PeterPtroc/DDCA_project/constraints/nexys_a7_100t.xdc

# Nexys A7-100T pin constraints for nexys_a7_top.
# Source: https://github.com/Digilent/digilent-xdc/blob/master/Nexys-A7-100T-Master.xdc

## The original pin-only file omitted configuration-bank voltage properties,
## which raised CFGBVS-1. These are the Nexys A7 master-XDC values.
set_property CFGBVS VCCO [current_design]
set_property CONFIG_VOLTAGE 3.3 [current_design]

## 100 MHz system clock
set_property -dict { PACKAGE_PIN E3 IOSTANDARD LVCMOS33 } [get_ports {clk100}]
create_clock -add -name sys_clk -period 10.000 -waveform {0.000 5.000} [get_ports {clk100}]

## CPU_RESETN push button (active low)
set_property -dict { PACKAGE_PIN C12 IOSTANDARD LVCMOS33 } [get_ports {reset_n}]

## Slide switches
set_property -dict { PACKAGE_PIN J15 IOSTANDARD LVCMOS33 } [get_ports {sw[0]}]
set_property -dict { PACKAGE_PIN L16 IOSTANDARD LVCMOS33 } [get_ports {sw[1]}]
set_property -dict { PACKAGE_PIN M13 IOSTANDARD LVCMOS33 } [get_ports {sw[2]}]
set_property -dict { PACKAGE_PIN R15 IOSTANDARD LVCMOS33 } [get_ports {sw[3]}]
set_property -dict { PACKAGE_PIN R17 IOSTANDARD LVCMOS33 } [get_ports {sw[4]}]
set_property -dict { PACKAGE_PIN T18 IOSTANDARD LVCMOS33 } [get_ports {sw[5]}]
set_property -dict { PACKAGE_PIN U18 IOSTANDARD LVCMOS33 } [get_ports {sw[6]}]
set_property -dict { PACKAGE_PIN R13 IOSTANDARD LVCMOS33 } [get_ports {sw[7]}]
set_property -dict { PACKAGE_PIN T8  IOSTANDARD LVCMOS18 } [get_ports {sw[8]}]
set_property -dict { PACKAGE_PIN U8  IOSTANDARD LVCMOS18 } [get_ports {sw[9]}]
set_property -dict { PACKAGE_PIN R16 IOSTANDARD LVCMOS33 } [get_ports {sw[10]}]
set_property -dict { PACKAGE_PIN T13 IOSTANDARD LVCMOS33 } [get_ports {sw[11]}]
set_property -dict { PACKAGE_PIN H6  IOSTANDARD LVCMOS33 } [get_ports {sw[12]}]
set_property -dict { PACKAGE_PIN U12 IOSTANDARD LVCMOS33 } [get_ports {sw[13]}]
set_property -dict { PACKAGE_PIN U11 IOSTANDARD LVCMOS33 } [get_ports {sw[14]}]
set_property -dict { PACKAGE_PIN V10 IOSTANDARD LVCMOS33 } [get_ports {sw[15]}]

## User LEDs
set_property -dict { PACKAGE_PIN H17 IOSTANDARD LVCMOS33 } [get_ports {led[0]}]
set_property -dict { PACKAGE_PIN K15 IOSTANDARD LVCMOS33 } [get_ports {led[1]}]
set_property -dict { PACKAGE_PIN J13 IOSTANDARD LVCMOS33 } [get_ports {led[2]}]
set_property -dict { PACKAGE_PIN N14 IOSTANDARD LVCMOS33 } [get_ports {led[3]}]
set_property -dict { PACKAGE_PIN R18 IOSTANDARD LVCMOS33 } [get_ports {led[4]}]
set_property -dict { PACKAGE_PIN V17 IOSTANDARD LVCMOS33 } [get_ports {led[5]}]
set_property -dict { PACKAGE_PIN U17 IOSTANDARD LVCMOS33 } [get_ports {led[6]}]
set_property -dict { PACKAGE_PIN U16 IOSTANDARD LVCMOS33 } [get_ports {led[7]}]
set_property -dict { PACKAGE_PIN V16 IOSTANDARD LVCMOS33 } [get_ports {led[8]}]
set_property -dict { PACKAGE_PIN T15 IOSTANDARD LVCMOS33 } [get_ports {led[9]}]
set_property -dict { PACKAGE_PIN U14 IOSTANDARD LVCMOS33 } [get_ports {led[10]}]
set_property -dict { PACKAGE_PIN T16 IOSTANDARD LVCMOS33 } [get_ports {led[11]}]
set_property -dict { PACKAGE_PIN V15 IOSTANDARD LVCMOS33 } [get_ports {led[12]}]
set_property -dict { PACKAGE_PIN V14 IOSTANDARD LVCMOS33 } [get_ports {led[13]}]
set_property -dict { PACKAGE_PIN V12 IOSTANDARD LVCMOS33 } [get_ports {led[14]}]
set_property -dict { PACKAGE_PIN V11 IOSTANDARD LVCMOS33 } [get_ports {led[15]}]

## RGB LEDs. Pins copied from the official Digilent Nexys-A7-100T Master XDC.
set_property -dict { PACKAGE_PIN N15 IOSTANDARD LVCMOS33 } [get_ports {rgb0_r}]
set_property -dict { PACKAGE_PIN M16 IOSTANDARD LVCMOS33 } [get_ports {rgb0_g}]
set_property -dict { PACKAGE_PIN R12 IOSTANDARD LVCMOS33 } [get_ports {rgb0_b}]
set_property -dict { PACKAGE_PIN N16 IOSTANDARD LVCMOS33 } [get_ports {rgb1_r}]
set_property -dict { PACKAGE_PIN R11 IOSTANDARD LVCMOS33 } [get_ports {rgb1_g}]
set_property -dict { PACKAGE_PIN G14 IOSTANDARD LVCMOS33 } [get_ports {rgb1_b}]

## Navigation buttons: center, up, left, right, down
set_property -dict { PACKAGE_PIN N17 IOSTANDARD LVCMOS33 } [get_ports {btn[0]}]
set_property -dict { PACKAGE_PIN M18 IOSTANDARD LVCMOS33 } [get_ports {btn[1]}]
set_property -dict { PACKAGE_PIN P17 IOSTANDARD LVCMOS33 } [get_ports {btn[2]}]
set_property -dict { PACKAGE_PIN M17 IOSTANDARD LVCMOS33 } [get_ports {btn[3]}]
set_property -dict { PACKAGE_PIN P18 IOSTANDARD LVCMOS33 } [get_ports {btn[4]}]

## FPGA-to-PC USB-UART. Digilent names D4 UART_RXD_OUT from the PC/DTE side.
set_property -dict { PACKAGE_PIN D4 IOSTANDARD LVCMOS33 } [get_ports {uart_tx}]
## PC-to-FPGA USB-UART receive path.
set_property -dict { PACKAGE_PIN C4 IOSTANDARD LVCMOS33 } [get_ports {uart_rx}]

## Eight-digit seven-segment display (all signals active low).
set_property -dict { PACKAGE_PIN T10 IOSTANDARD LVCMOS33 } [get_ports {seg[0]}]
set_property -dict { PACKAGE_PIN R10 IOSTANDARD LVCMOS33 } [get_ports {seg[1]}]
set_property -dict { PACKAGE_PIN K16 IOSTANDARD LVCMOS33 } [get_ports {seg[2]}]
set_property -dict { PACKAGE_PIN K13 IOSTANDARD LVCMOS33 } [get_ports {seg[3]}]
set_property -dict { PACKAGE_PIN P15 IOSTANDARD LVCMOS33 } [get_ports {seg[4]}]
set_property -dict { PACKAGE_PIN T11 IOSTANDARD LVCMOS33 } [get_ports {seg[5]}]
set_property -dict { PACKAGE_PIN L18 IOSTANDARD LVCMOS33 } [get_ports {seg[6]}]
set_property -dict { PACKAGE_PIN H15 IOSTANDARD LVCMOS33 } [get_ports {seg_dp}]
set_property -dict { PACKAGE_PIN J17 IOSTANDARD LVCMOS33 } [get_ports {seg_an[0]}]
set_property -dict { PACKAGE_PIN J18 IOSTANDARD LVCMOS33 } [get_ports {seg_an[1]}]
set_property -dict { PACKAGE_PIN T9  IOSTANDARD LVCMOS33 } [get_ports {seg_an[2]}]
set_property -dict { PACKAGE_PIN J14 IOSTANDARD LVCMOS33 } [get_ports {seg_an[3]}]
set_property -dict { PACKAGE_PIN P14 IOSTANDARD LVCMOS33 } [get_ports {seg_an[4]}]
set_property -dict { PACKAGE_PIN T14 IOSTANDARD LVCMOS33 } [get_ports {seg_an[5]}]
set_property -dict { PACKAGE_PIN K2  IOSTANDARD LVCMOS33 } [get_ports {seg_an[6]}]
set_property -dict { PACKAGE_PIN U13 IOSTANDARD LVCMOS33 } [get_ports {seg_an[7]}]

## Eight fixed test outputs on Pmod JA; JB1 remains the only scope input.
set_property -dict { PACKAGE_PIN C17 IOSTANDARD LVCMOS33 } [get_ports {pmod_ja[0]}]
set_property -dict { PACKAGE_PIN D18 IOSTANDARD LVCMOS33 } [get_ports {pmod_ja[1]}]
set_property -dict { PACKAGE_PIN E18 IOSTANDARD LVCMOS33 } [get_ports {pmod_ja[2]}]
set_property -dict { PACKAGE_PIN G17 IOSTANDARD LVCMOS33 } [get_ports {pmod_ja[3]}]
set_property -dict { PACKAGE_PIN D17 IOSTANDARD LVCMOS33 } [get_ports {pmod_ja[4]}]
set_property -dict { PACKAGE_PIN E17 IOSTANDARD LVCMOS33 } [get_ports {pmod_ja[5]}]
set_property -dict { PACKAGE_PIN F18 IOSTANDARD LVCMOS33 } [get_ports {pmod_ja[6]}]
set_property -dict { PACKAGE_PIN G18 IOSTANDARD LVCMOS33 } [get_ports {pmod_ja[7]}]
set_property -dict { PACKAGE_PIN D14 IOSTANDARD LVCMOS33 } [get_ports {jb1}]

## The original file left board I/O without delays, producing TIMING-18 and
## check_timing HIGH findings. These controls and capture pins are asynchronous,
## while the status/UART/PWM outputs have no external source-synchronous timing
## contract, so encode that intent explicitly instead of inventing I/O delays.
set_false_path -from [get_ports {reset_n sw[*] btn[*] jb1 uart_rx}]
set_false_path -to [get_ports {led[*] uart_tx pmod_ja[*] seg[*] seg_an[*] seg_dp rgb0_r rgb0_g rgb0_b rgb1_r rgb1_g rgb1_b}]
