PeterPtroc/DDCA_project/(commit log)

2026-09-30 完成仿真和综合
2026-10-01 完成初步逻辑分析仪设计
2026-10-01 完善设计
2026-10-02 交由cpu计算
2026-10-03 更新文档
2026-10-05 [feat] 添加gui启动器
2026-10-08 [fix] 防止切换分支复用过期构建产物
